Hunter259/JetsonPowerMgmtFirmware/README.md

# JetsonPowerMgmtFirmware
IPMI firmware for STM32 devices to control the Jetson Power Mangement Module
