Hunter259/JetsonPowerMgmtFirmware/JetsonR&D/PMMRouted.png

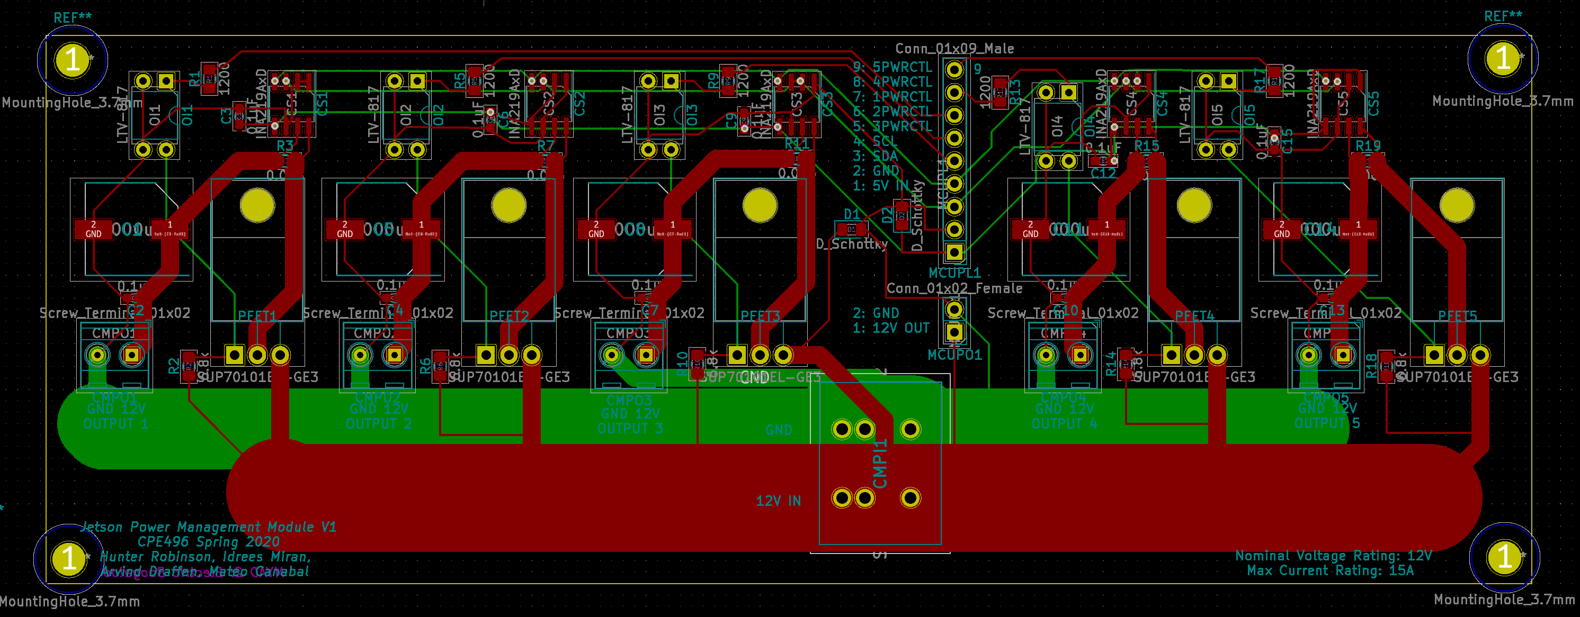
JetsonR&D/PMMRouted.png
