Hunter259/JetsonPowerMgmtFirmware/JetsonR&D/PMMSchematic.png

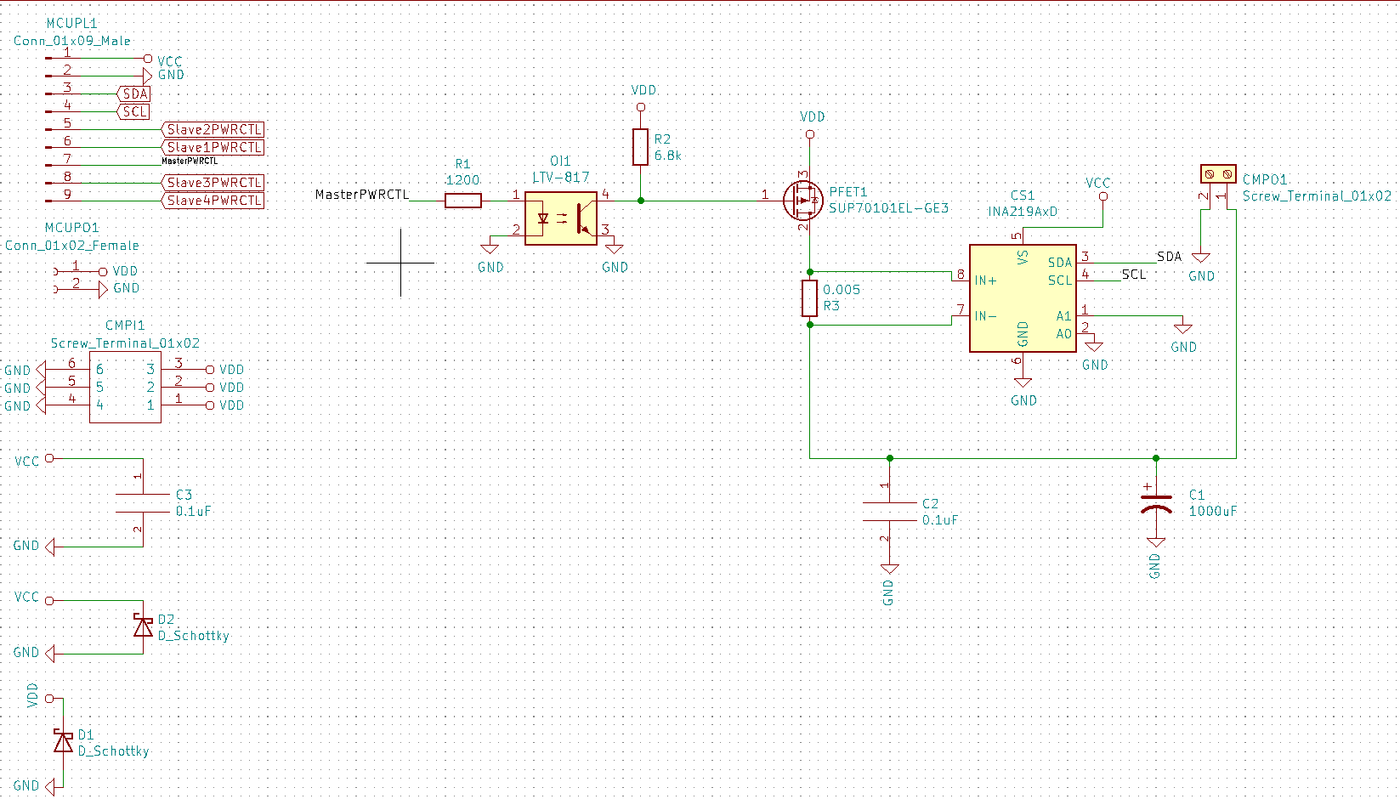
JetsonR&D/PMMSchematic.png
