Hunter259/JetsonPowerMgmtFirmware/JetsonR&D/PMSPricing.xlsx

System Type: Power Management | Quantity | Price Per Unit (Without Tax) | Total Price | Store Link | Notes
Management Controller: STMicro Nucleo F429ZI | 1 | 24.47 | 24.47 | https://www.digikey.com/product-detail/en/stmicroelectronics/NUCLEO-F746ZG/497-16282-ND/5806779
Power Switching Circuit (OshPark) | 1 | 78.15 | 78.15 | https://oshpark.com/
Output Power Connector Header | 10 | 0.337 | 3.37 | https://www.digikey.com/product-detail/en/OSTOQ023250/ED2819-ND/1588099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
Output Power Connecter Plug | 10 | 1.266 | 12.66 | https://www.digikey.com/product-detail/en/on-shore-technology-inc/EDZ1700-2/ED2454-ND/299752
12V Input Power Header | 1 | 3.07 | 3.07 | https://www.digikey.com/product-detail/en/phoenix-contact/1720576/277-7462-ND/3596800/
12V Input Power Plug | 1 | 4.03 | 4.03 | https://www.digikey.com/product-detail/en/phoenix-contact/1777723/277-2434-ND/2743635
Vishay Siliconix SUP70101EL-GE3 MOSFET | 5 | 2.83 | 14.15 | https://www.digikey.com/product-detail/en/vishay-siliconix/SUP70101EL-GE3/SUP70101EL-GE3-ND/7622840?slid=
Lite-On LTV-817 Optoisolator | 5 | 0.41 | 2.05 | https://www.digikey.com/product-detail/en/lite-on-inc/LTV-817/160-1366-5-ND/385836/
Texas Instruments INA219AIDR Current Sensor | 5 | 2.36 | 11.8 | https://www.digikey.com/product-detail/en/texas-instruments/INA219AIDR/296-23978-1-ND/1984895
1000uf Filter Cap | 10 | 0.744 | 7.44 | https://www.digikey.com/product-detail/en/united-chemi-con/EMZS250ARA102MJA0G/565-5120-1-ND/8637115/
Current Sense 0.005OHM | 10 | 0.417 | 4.17 | https://www.digikey.com/product-detail/en/bourns-inc/CRF0805-FZ-R005ELF/CRF0805-FZ-R005ELFCT-ND/6211159
2.1mm x 5.5mm Single Male End Cable 18 AWG | 5 | 3.34 | 16.7 | https://www.digikey.com/product-detail/en/mpd-memory-protection-devices/172-4207/172-4207-ND/2439191
ESD Schottky | 10 | 0.333 | 3.33 | https://www.digikey.com/product-detail/en/avx-corporation/SD0805S020S0R5/478-7799-1-ND/3749477
6.8K Gate Pull Up | 10 | 0.026 | 0.26 | https://www.digikey.com/product-detail/en/stackpole-electronics-inc/RMCF0805FT6K80/RMCF0805FT6K80CT-ND/1942425
1.2K Opto Resistor | 10 | 0.026 | 0.26 | https://www.digikey.com/product-detail/en/stackpole-electronics-inc/RMCF0805FT1K20/RMCF0805FT1K20CT-ND/2418296
MCU Output Connector | 1 | 0.33 | 0.33 | https://www.digikey.com/product-detail/en/sullins-connector-solutions/PPPC021LFBN-RC/S7035-ND/810174
MCU Logic Connector | 1 | 0.28 | 0.28 | https://www.digikey.com/product-detail/en/sullins-connector-solutions/PRPC009SAAN-RC/S1011EC-09-ND/2775245
2 Pin Housing | 1 | 0.69 | 0.69 | https://www.digikey.com/products/en?KeyWords=1901&WT.z_header=search_go&v=2183
9 Pin Housing | 1 | 1.09 | 1.09 | https://www.digikey.com/products/en?KeyWords=1908&WT.z_header=search_go&v=2183
3" Assortment Pre-Crimped Wires | 1 | 8.95 | 8.95 | https://www.digikey.com/products/en?KeyWords=1807&WT.z_header=search_go&v=2183
 | Total Without Tax Estimation: | 133.149
UAH does not pay taxes on Digikey purchases. OSHPark was only | (Not applicable)Total With Tax Estimation: | 215.0025
taxed item.
