Hunter259/JetsonPowerMgmtFirmware/(list of files, drawings)

Other design files:
JetsonR&D/Jetson2R&D.dsn
