Hunter259/JetsonPowerMgmtFirmware/JetsonR&D/Jetson2R&D.kicad_pcb

## KiCad design JetsonR&D/Jetson2R&D.kicad_pcb (2020-04-27)

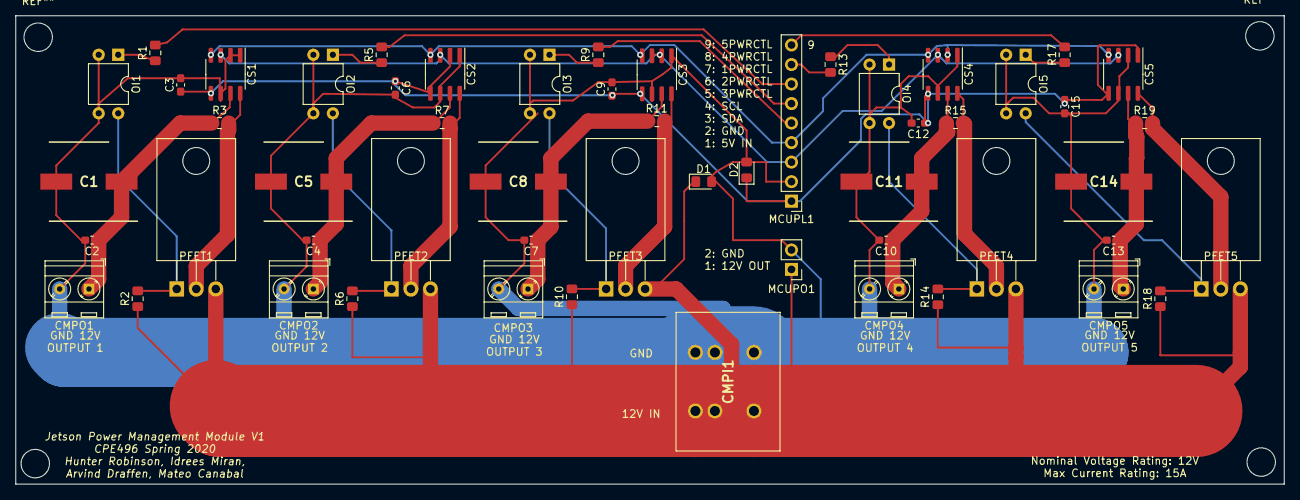
[picture p3: board Jetson2R&D.kicad_pcb from above]

Board: 2 copper layers, 165.1 x 61.0 mm, 55 parts (0 on the bottom side), 30 nets.

Parts:
C1, C5, C8, C11, C14: 1000uF; CAPAE1030X1050N
C2, C3, C4, C6, C7, C9, C10, C12, C13, C15: 0.1uF; C_0603_1608Metric_Pad1.05x0.95mm_HandSolder
CMPI1: Screw_Terminal_01x02; 1720576
CMPO1, CMPO2, CMPO3, CMPO4, CMPO5: Screw_Terminal_01x02; TerminalBlock_MetzConnect_Type086_RT03402HBLC_1x02_P3.81mm_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
CS1, CS2, CS3, CS4, CS5: INA219AxD; SOIC-8_3.9x4.9mm_P1.27mm
D1, D2: D_Schottky; D_0805_2012Metric_Pad1.15x1.40mm_HandSolder
MCUPL1: Conn_01x09_Male; PinHeader_1x09_P2.54mm_Vertical
MCUPO1: Conn_01x02_Female; PinHeader_1x02_P2.54mm_Vertical
OI1, OI2, OI3, OI4, OI5: LTV-817; DIP-4_W7.62mm
PFET1, PFET2, PFET3, PFET4, PFET5: SUP70101EL-GE3; TO-220-3_Horizontal_TabDown
R1, R5, R9, R13, R17: 1200; R_0805_2012Metric_Pad1.15x1.40mm_HandSolder
R2, R6, R10, R14, R18: 6.8k; R_0805_2012Metric_Pad1.15x1.40mm_HandSolder
R3, R7, R11, R15, R19: 0.005; R_0805_2012Metric_Pad1.15x1.40mm_HandSolder

Connections:
/MasterPWRCTL: MCUPL1.7, R1.2
GND: C1.2, C2.2, C3.2, C4.2, C5.2, C6.2, C7.2, C8.2, C9.2, C10.2, C11.2, C12.2, C13.2, C14.2, C15.2, CMPI1.4, CMPI1.5, CMPI1.6, CMPO1.2, CMPO2.2, CMPO3.2, CMPO4.2, CMPO5.2, CS1.1, CS1.2, CS1.6, CS2.1, CS2.6, CS3.1, CS3.6, CS4.1, CS4.6, CS5.2, CS5.6, D1.2, D2.2, MCUPL1.2, MCUPO1.2, OI1.2, OI1.3, OI2.2, OI2.3, OI3.2, OI3.3, OI4.2, OI4.3, OI5.2, OI5.3
unnamed: C1.1, C2.1, CMPO1.1, CS1.7, R3.1
unnamed: C4.1, C5.1, CMPO2.1, CS2.7, R7.1
unnamed: C7.1, C8.1, CMPO3.1, CS3.7, R11.1
unnamed: C10.1, C11.1, CMPO4.1, CS4.7, R15.1
unnamed: C13.1, C14.1, CMPO5.1, CS5.7, R19.1
unnamed: CS1.8, PFET1.2, R3.2
unnamed: CS2.8, PFET2.2, R7.2
unnamed: CS3.8, PFET3.2, R11.2
unnamed: CS4.8, PFET4.2, R15.2
unnamed: CS5.8, PFET5.2, R19.2
unnamed: OI1.1, R1.1
unnamed: OI1.4, PFET1.1, R2.2
unnamed: OI2.1, R5.1
unnamed: OI2.4, PFET2.1, R6.2
unnamed: OI3.1, R9.1
unnamed: OI3.4, PFET3.1, R10.2
unnamed: OI4.1, R13.1
unnamed: OI4.4, PFET4.1, R14.2
unnamed: OI5.1, R17.1
unnamed: OI5.4, PFET5.1, R18.2
SCL: CS1.4, CS2.4, CS3.4, CS4.2, CS4.4, CS5.4, MCUPL1.4
SDA: CS1.3, CS2.3, CS3.2, CS3.3, CS4.3, CS5.3, MCUPL1.3
Slave1PWRCTL: MCUPL1.6, R5.2
Slave2PWRCTL: MCUPL1.5, R9.2
Slave3PWRCTL: MCUPL1.8, R13.2
Slave4PWRCTL: MCUPL1.9, R17.2
VCC: C3.1, C6.1, C9.1, C12.1, C15.1, CS1.5, CS2.2, CS2.5, CS3.5, CS4.5, CS5.1, CS5.5, D2.1, MCUPL1.1
VDD: CMPI1.1, CMPI1.2, CMPI1.3, D1.1, MCUPO1.1, PFET1.3, PFET2.3, PFET3.3, PFET4.3, PFET5.3, R2.1, R6.1, R10.1, R14.1, R18.1
