Hunter259/JetsonPowerMgmtFirmware/(commit log)

2020-04-16 Finished initial configuration of INA219 Added reading bus voltage and currents from single INA219's and from all INA219's Added register enumeration for better readability
2020-04-16 Added GPIOPinDefs structure for ease of use. Finished constructor with power set to off at default. Added independent power control functions. Added entire cluster power control functions.
2020-04-27 Added the Jetson PMS schematics and routing for ease of access.
    [Jetson2.0R&DSlave1.sch, Jetson2.0R&DSlave2.sch, Jetson2.0R&DSlave4.sch, Jetson2R&D.dsn, Jetson2R&D.kicad_pcb, Jetson2R&D.sch, Jetson2R&DSlave3.sch, PMSPricing.xlsx]
